f4bms/Roomba-Disco/Modelos3D/Aspirador/lid_70_borde.stl

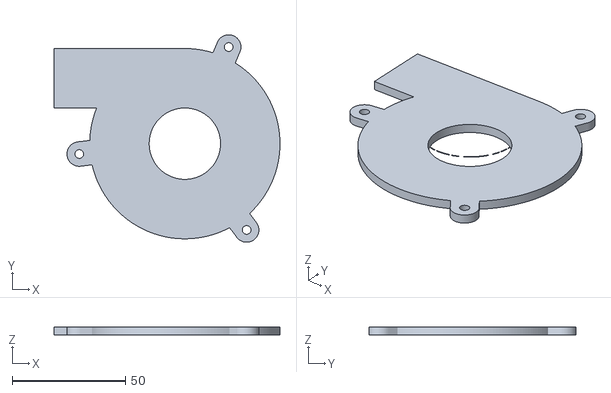
[picture p1: CAD file, 2026-10-04]
Modelos3D/Aspirador/lid_70_borde.stl
99.8 x 91.6 x 9.50
