f4bms/Roomba-Disco/Modelos3D/Deposito/deposito_cuerpo.stl

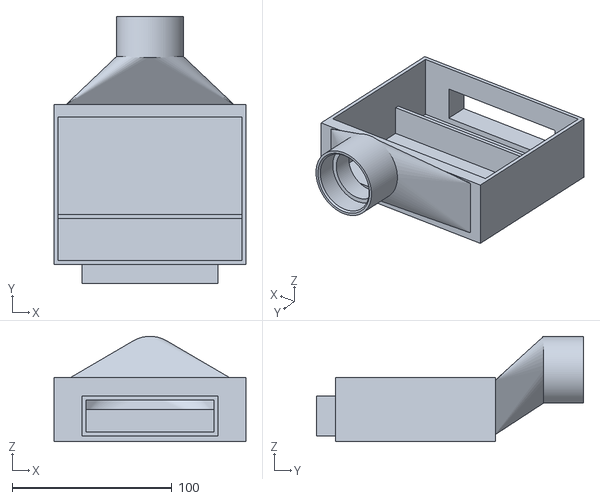
[picture p2: CAD file, 2026-10-04]
Modelos3D/Deposito/deposito_cuerpo.stl
120.0 x 167.0 x 65.9
