f4bms/Roomba-Disco/Modelos3D/solo caracol/impeller_70.stl

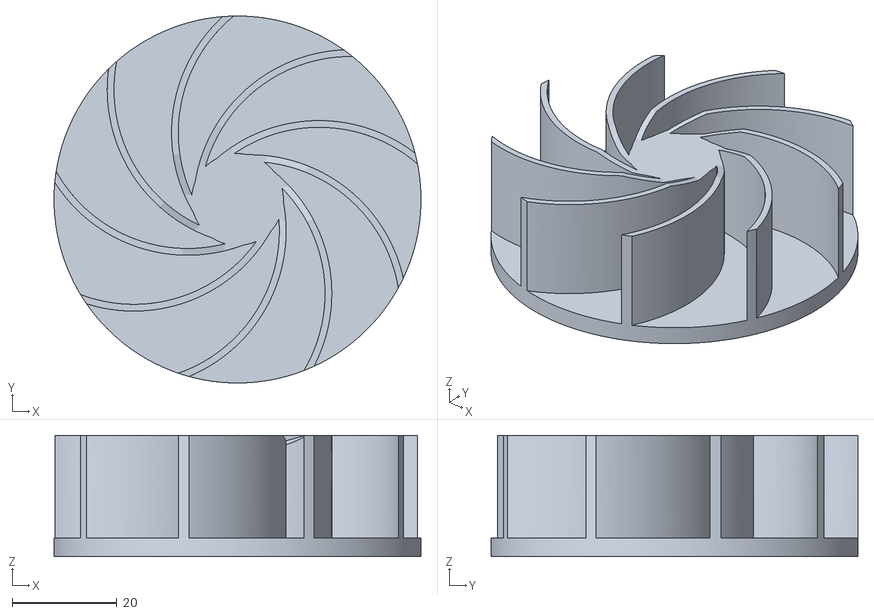
[picture p3: CAD file, 2026-10-04]
Modelos3D/solo caracol/impeller_70.stl
70.0 x 70.0 x 23.1
