f4bms/Roomba-Disco/Modelos3D/todo en piecitas separadas/soporte_motor_70.stl

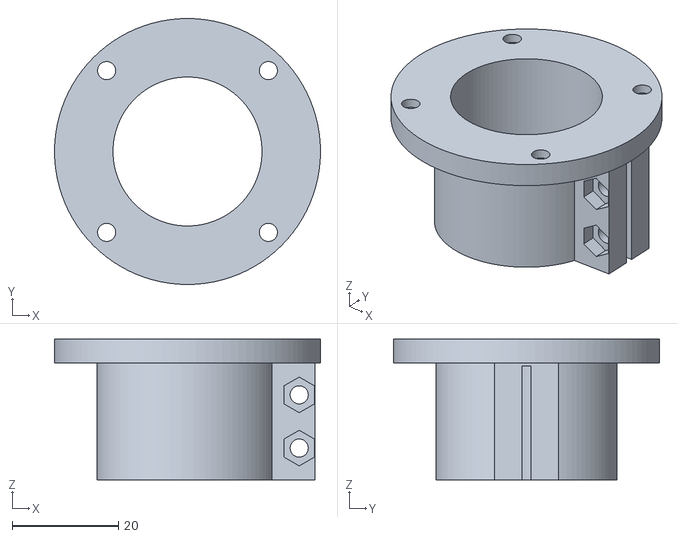
[picture p4: CAD file, 2026-10-04]
Modelos3D/todo en piecitas separadas/soporte_motor_70.stl
50.0 x 50.0 x 26.5
