f4bms/Roomba-Disco/Modelos3D/Aspirador/case_70_motor.stl

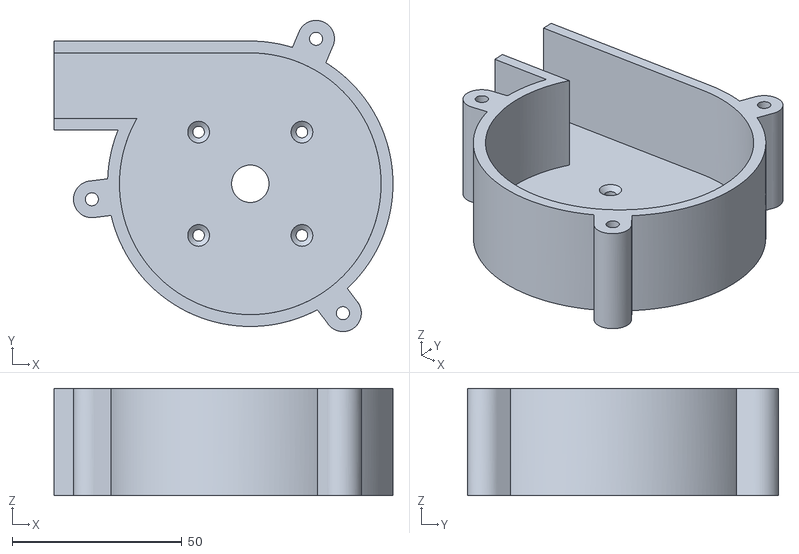
[picture p5: CAD file, 2026-10-04]
Modelos3D/Aspirador/case_70_motor.stl
99.8 x 91.6 x 31.5
