f4bms/Roomba-Disco/Modelos3D/Deposito/boquilla.stl

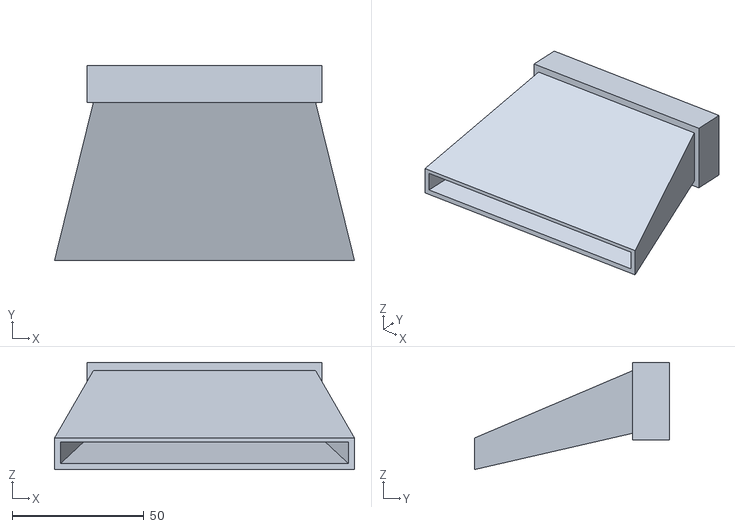
[picture p6: CAD file, 2026-10-04]
Modelos3D/Deposito/boquilla.stl
114.0 x 74.0 x 40.7
