f4bms/Roomba-Disco/Modelos3D/Deposito/deposito_tapa.stl

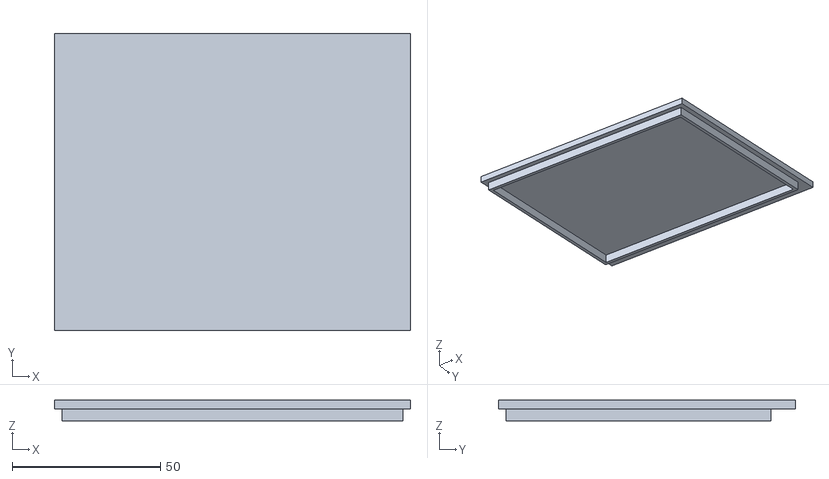
[picture p7: CAD file, 2026-10-04]
Modelos3D/Deposito/deposito_tapa.stl
120.0 x 100.0 x 7.00
