f4bms/Roomba-Disco/Modelos3D/solo caracol/lid_70.stl

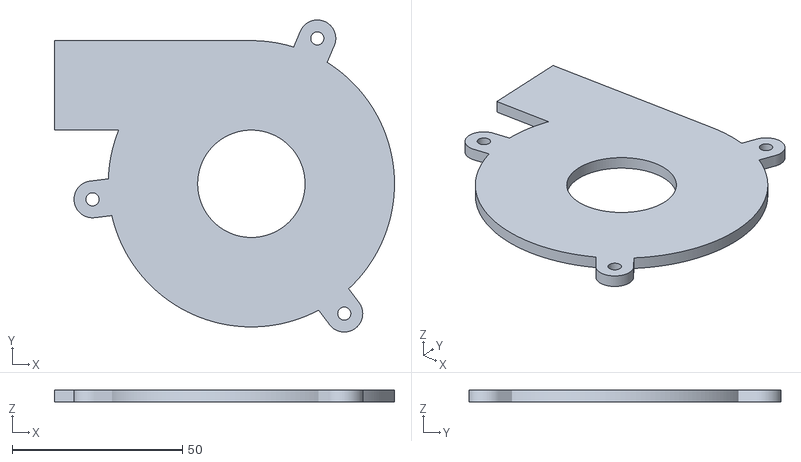
[picture p8: CAD file, 2026-10-04]
Modelos3D/solo caracol/lid_70.stl
99.8 x 91.6 x 3.50
