f4bms/Roomba-Disco/Modelos3D/todo en piecitas separadas/deposito_cuerpo.stl

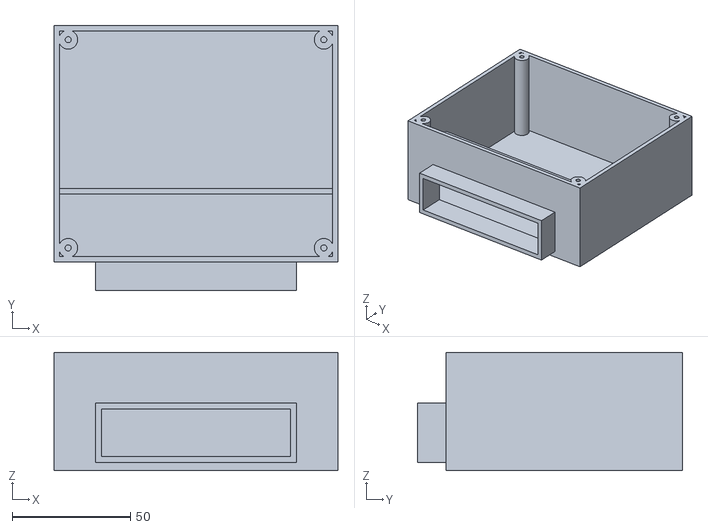
[picture p9: CAD file, 2026-10-04]
Modelos3D/todo en piecitas separadas/deposito_cuerpo.stl
120.0 x 112.0 x 50.0
