f4bms/Roomba-Disco/Modelos3D/todo en piecitas separadas/canal_filtro_70.stl

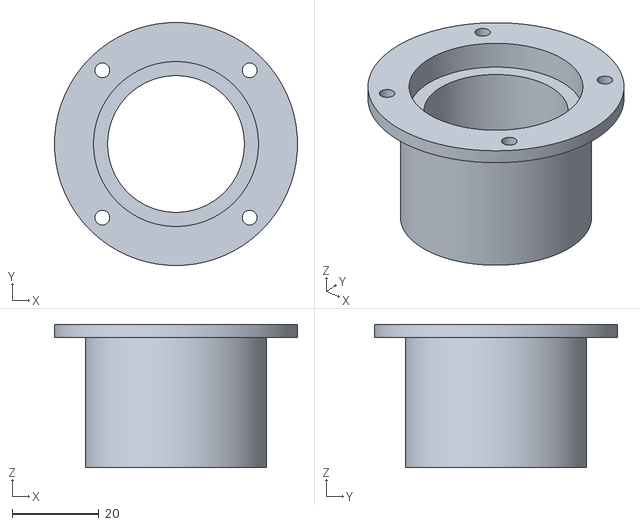
[picture p10: CAD file, 2026-10-04]
Modelos3D/todo en piecitas separadas/canal_filtro_70.stl
56.0 x 56.0 x 33.0
