f4bms/Roomba-Disco/Modelos3D/todo en piecitas separadas/deposito_tapa.stl

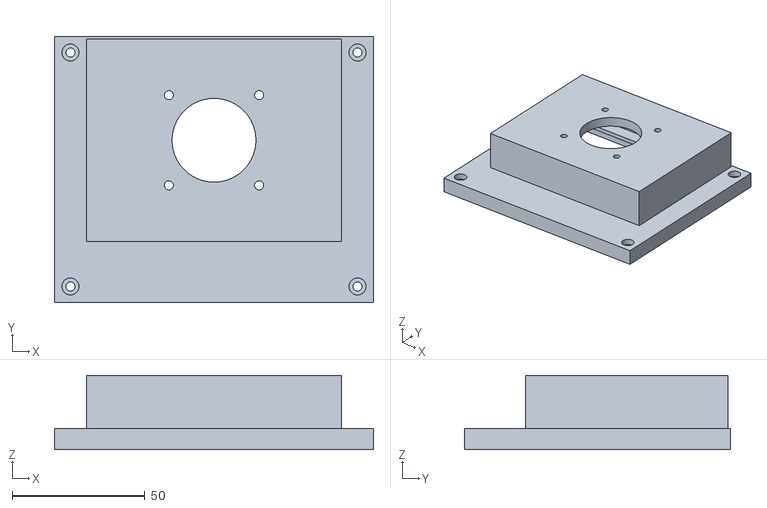
[picture p11: CAD file, 2026-10-04]
Modelos3D/todo en piecitas separadas/deposito_tapa.stl
120.0 x 100.0 x 28.0
