f4bms/Roomba-Disco/(list of files, cad)

Other CAD files:
Modelos3D/Aspira.blend
