f4bms/Roomba-Disco/(commit log)

2026-09-05 chore(cliente): importar base de SCRAP-E_Controller desde rama development
2026-09-06 feat: agregar servidor WebSocket de prueba y conexión del cliente Angular
    - agregar servidor WebSocket mínimo en C con soporte de compilación mediante CMake
    - registrar conexiones y desconexiones de clientes
    - devolver mediante echo los mensajes de texto recibidos
    - agregar controles Angular para conectar, desconectar y probar el servidor
    - ignorar artefactos generados por CMake y las compilaciones locales
2026-09-06 feat(cliente): reestructurar interfaz al panel principal del robot
    - agregar pantalla de dashboard con columnas de estado, audio, mapa y control
    - agregar panel de audio con lista de reproducción y controles de transporte
    - agregar vista de mapa en grilla con celdas visitada/obstáculo/desconocida
    - reutilizar el joystick y agregar botón de modo, sensores y slider de velocidad
    - establecer el dashboard como ruta principal
    - simplificar el navbar quitando el menú lateral y renombrar a "Disco Roomba"
    - ignorar UI.md en el control de versiones
2026-09-11 docs(hardware): añade sección y diagrama de arquitectura de hardware al README
    Nueva sección "Arquitectura de hardware" en el README con el diagrama de
    bloques (D2) de los cuatro dominios —energía, lógico, barrera de aislamiento
    y potencia—, las señales de control entre ellos y una tabla con las
    decisiones de hardware todavía por definir.
    Incluye la fuente reproducible (diagramas/arquitectura-hardware.d2) y el SVG
    renderizado que embebe el README.
    Refs #46, #21, #22
2026-09-11 docs: update README.md
    Esqueleto con todas las partes que van en el README dejando como pendientes las que todavía no hemos completado.
2026-09-12 feat(cliente-servidor): habilitar control remoto de prueba por WebSocket
    - integrar CivetWeb vendorizado para servir el cliente Angular y WebSocket en un solo proceso
    - compilar e instalar el cliente web mediante CMake junto con el servidor
    - agregar servicio Angular que conecta al WebSocket del mismo origen
    - enviar comandos de modo, dirección, velocidad y audio desde el dashboard
    - registrar temporalmente en el servidor las acciones recibidas del cliente
    - habilitar los controles del panel durante las pruebas sin capa Lógica
    - eliminar estados simulados de sensores, mapa y lista de reproducción
    - actualizar documentación de despliegue y reglas de archivos ignorados
2026-09-13 feat(hardware): agrega biblioteca roombateca con motores, sensores, leds y audio
    Biblioteca compartida (CMake, sin cross-compilar todavía): motores.c
    implementa el control temporal de motor_izquierdo_set/derecho_set
    validando rango y estado; sensores.c y leds.c traen get_distance y
    ledSet literales de la rama yocto (thgpio.c), sin implementación real
    todavía; audio_th.c reproduce notificaciones MP3 en un hilo aparte vía
    mpg123; roombateca.c agrega una función básica para elegir pista por
    índice.
2026-09-13 chore(script): agrega script de sync/push entre la rama actual y development
    Pushea la rama actual a origin, trae origin/development a la rama
    actual, fusiona la rama actual en development, y pushea development
    también.
2026-09-13 fix(script): pregunta antes de continuar si hay cambios sin commitear
    Antes cortaba directo con exit 1; ahora muestra el git status y
    pregunta si continuar de todas formas.
2026-09-13 fix(script): corrige el mensaje final de sync-push.sh
    Decía "development actualizada en local", pero development también se
    pushea.
2026-09-13 fix(script): corrige el comentario del encabezado de sync-push.sh
    Decía que development no se pushea ahí; sí se pushea.
2026-09-13 fix(script): generaliza el comentario de ubicación en sync-push.sh
    Decía "workarea/Roomba-Disco", una ruta personal; ahora dice "raíz
    del repo", válido para cualquiera que lo clone.
2026-09-14 feat(comunicacion): integrar estado JSON entre cliente servidor y logica
    Reemplaza los mensajes delimitados por snapshots y parches JSON.
    Conecta CivetWeb con el proceso de Logica mediante un socket Unix.
    Agrega persistencia del estado y una prueba de integracion completa.
2026-09-15 feat(hardware): agrega roombateca_ping como healthcheck de la biblioteca
    Permite que el servidor confirme al arrancar que libroombateca está
    cargada, sin tocar hardware.
2026-09-15 fix(hardware): corrige referencias a libthgpio por libroombateca en el README
    El README seguía nombrando la biblioteca por su nombre anterior en el
    diagrama de capas, la receta de Yocto y la sección de documentación de
    la API.
2026-09-15 build(yocto): agrega capa meta-robot y configuración de imagen para audio
    Receta libroombateca_1.0.bb (enlaza Biblioteca/ vía FILESEXTRAPATHS),
    bbappends de kernel y mpg123 para habilitar el backend de audio ALSA, y
    el local.conf con los paquetes y overlays necesarios (alsa, mpg123,
    módulo snd-bcm2835, pwm-2chan).
2026-09-15 docs(yocto): documenta cómo probar el entorno en una compu nueva
    Sección 9 en el README raíz (instalar el SDK, flashear la imagen, probar
    audio por SSH) y el anexo detallado en Yocto/README.md, con el flujo de
    devtool para iterar sobre la Pi sin reflashear.
2026-09-18 feat(hardware): agrega gpio_control basado en libgpiod v2
    Wrapper de pinMode/digitalWrite/digitalRead/blink sobre la API de
    character device de libgpiod v2, en vez de sysfs GPIO (deprecado).
    Refs #20
2026-09-18 build(yocto): agrega dependencia libgpiod a la receta libroombateca
    gpio_control.c enlaza contra libgpiod (API v2, char device).
2026-09-18 test(hardware): agrega aplicación de verificación de gpio_control
    Configura salidas/entrada, escribe valores binarios, hace blink y lee
    un pin. Usa pines placeholder hasta cerrar el mapa de asignación.
    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
2026-09-18 feat(logica): comunicación completa para motores desde el cliente hasta la biblioteca.
2026-09-19 build(yocto): agrega recetas de cliente, lógica y servidor
    Compilan el cliente Angular, la lógica y el servidor CivetWeb, y los instalan con sus unidades systemd. La imagen incluye servidor, que arrastra a las otras dos.
2026-09-19 build(yocto): agrega tailscale para acceso remoto de desarrollo
    Receta con los binarios estáticos oficiales, soporte TUN en el kernel y su entrada en IMAGE_INSTALL. Solo para desarrollo: se elimina antes de la entrega.
    [tun.cfg]
2026-09-26 feat(hardware): define la API de acceso al hardware de la biblioteca
    Agrega el mapa de pines de la Raspberry Pi 4 (lib/pinout.h, privado a
    la .so) y los headers de cada módulo: motores (L298N por PWM), sensores
    HC-SR04, LEDs de estado, audio, encoders F249 e IMU MPU6050, junto con
    el acceso a PWM por sysfs (lib/pwm_control.h).
    gpio_control suma pinModeEx (active-low, pull, flancos y debounce),
    waitEdge, edgeFd y pinRelease, sin cambiar la API existente.
    La biblioteca solo expone el hardware; el comportamiento (movimientos,
    umbral de obstáculo, pose y mapa, sonidos por evento) queda en Logica.
    Se mantienen las funciones de motores que ya usa Logica.
    Refs #24
    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
2026-09-26 build(yocto): habilita PWM en GPIO12/13, I2C1 y el jack de audio
    El overlay pwm-2chan no se empaquetaba en /boot/overlays, sin parámetros
    usaba GPIO18/19 y el módulo pwm-bcm2835 no entraba en la imagen, así que
    no había PWM por hardware. Se agrega el .dtbo, los parámetros para
    GPIO12/13 y el módulo con carga automática.
    También se habilita I2C1 con i2c-dev para el MPU6050 y dtparam=audio=on,
    que meta-raspberrypi solo agrega para raspberrypi3-64; sin él el kernel
    arranca con el jack deshabilitado.
    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
2026-09-26 feat(logica): configuracion de envio de datos no bloqueante hacia servidor
2026-09-27 feat(logic): se agregan cambios para implementación en simulación de odometria y mapa
2026-09-28 feat(comunicacion): separar cliente del servidor en la Pi
    Permite configurar y reconectar el WebSocket desde el cliente remoto. Desacopla Angular del build y del paquete Yocto del servidor.
    Publica snapshots periodicos desde Logica y verifica el intercambio bidireccional con la prueba de integracion.
2026-09-28 feat(integracion): agregar pruebas y estabilizar joystick
    Incorpora simuladores y herramientas manuales para probar cliente, servidor y Logica sin hardware real.
    Evita reenviar direcciones repetidas del joystick y cubre el cambio de direccion y STOP al soltar.
    El mapa y los sensores del cliente se actualizaron y validaron bajo el contrato JSON de snapshots en tiempo real.
    Closes #16
    Closes #18
2026-09-28 perf: audio listo para usar con majora en manejo de hilos
2026-09-28 test: add tests de audio, ej de como usar
2026-09-28 fix: delete variable de sonido no necesario
    [audio_th.h]
2026-10-01 feat(logic): fixed map and added features for communication with server
    [encoders.h, logica.c, mapa.c, mapa.h, odometria.c, roombateca_control.c]
2026-10-04 feat(leds): Logic integrated with leds
2026-10-04 feat(hardware): Add modelos 3D de módulo de aspiracion y depósito
    [Aspira.blend, boquilla.stl, canal_filtro_70.stl, case_70_motor.stl, deposito_cuerpo.stl, deposito_tapa.stl, impeller_70.stl, lid_70.stl]
